MatteoCancelli/Cappa_smart/(commit log)

2025-11-05 aggiunto task pir (accende led debug)
2025-11-06 cambiati gpio, add bottone e led modalità toggle per scelta regolazione manuale velocità ventola
2025-11-07 aggiunta flag nel caso di riavvio esp32 e gas_heater rileva già 40000 ohm (già ad una buona temperatura). tolta stampa seriale da task_aspirazione
2025-11-07 task_pir migliorata reattività e cambiato gpio (liberato gpio 2 led integrato)
2025-11-08 aggiunto utilizzo pwm
2025-11-28 tolte parti di codice inutilizzato e abbassato speed_wanted = map(pot, 0, 4095, 0, 180); per test
2026-04-12 aggiunto gpio per transistor che attiva la ventola
2026-04-12 refactoring estratte funzioni di logica pura
2026-04-13 integrata libreria ufficiale bosh, tolto warm up sensore
2026-04-13 salvo lo stato di calibrazione su flash esp32
2026-04-13 fix print
2026-04-14 cambiate frasi, cambiati valori di riferimento iaq, introdotta funzione dato iaq raw
2026-04-14 aggiunto air accuracy da lib bsec. la ventilazione parte solo quanto il sensore è calibrato
2026-04-15 gestita accuratezza sensore e wait finché non è calibrato
